JonasGMorsch/PI3/Proteus/placa esgrima.pdf

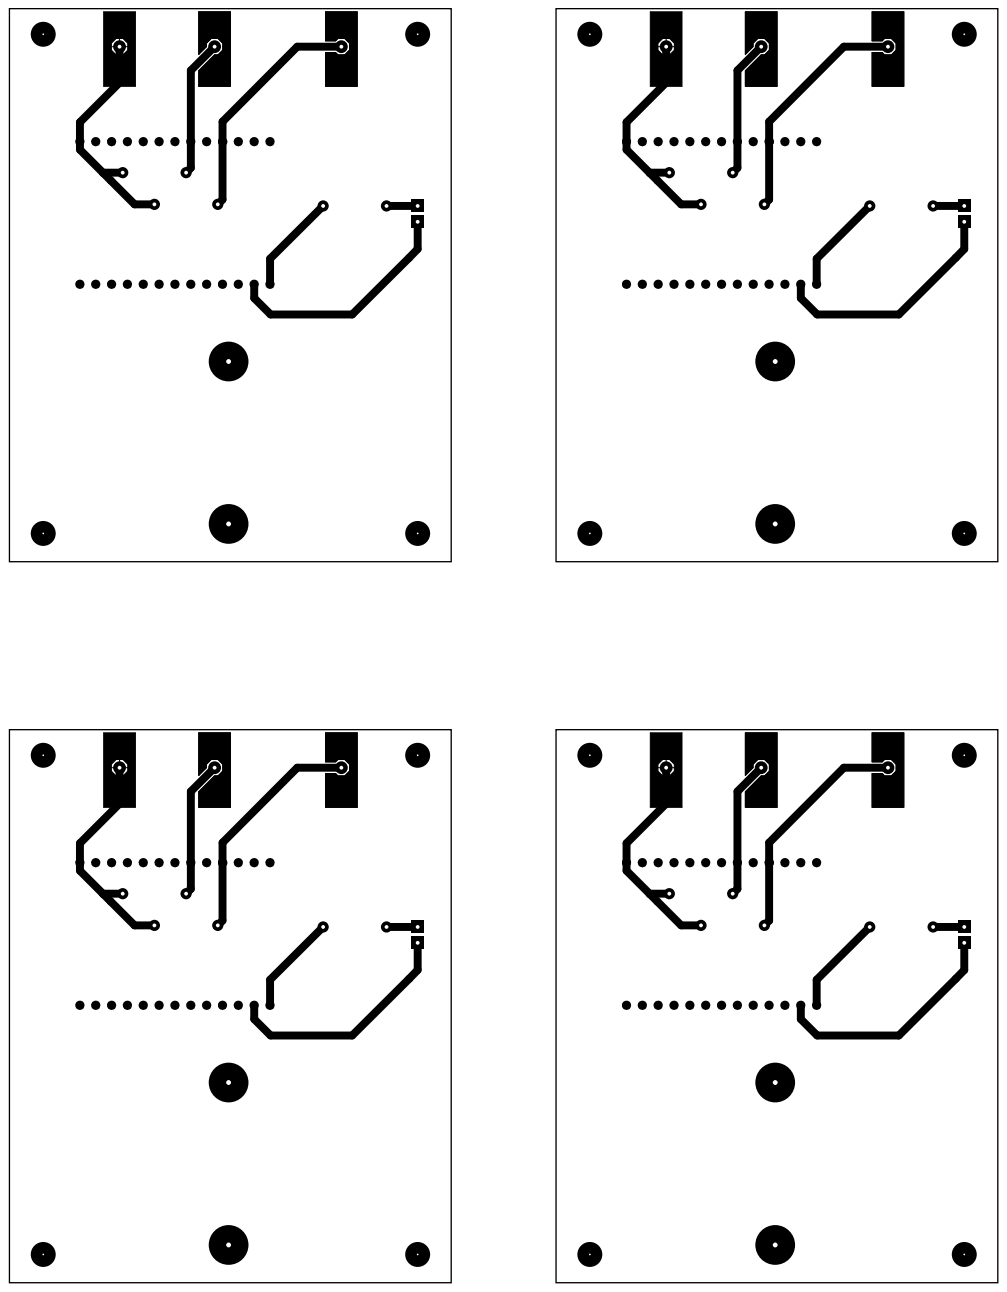
[picture p1: page 1]
