JonasGMorsch/PI3/(list of files, drawings)

Other design files:
Proteus/placa esgrima.pdsprj
Proteus/Teste Capacitancia 2.pdsprj
Proteus/Teste Capacitancia.pdsprj
