JonasGMorsch/PI3/(commit log)

2022-12-06 Movendo arquivos do projeto para o repositório
    [Teste Capacitancia.pdsprj, placa esgrima.pdsprj]
2022-12-06 movendo projetos de teste do ESP-IDF para o repositório
2022-12-07 devenvolvimento envio e recebmento via espnow
    [placa esgrima.pdsprj]
2022-12-07 desenvolvimento do timer & ADC
2022-12-09 testes com timers em hardware
2022-12-09 Passando tarefa de processamendo dos pacotes Wi-Fi para o core 1
2022-12-13 Habilitando Wi-Fi long range
    Este protocolo é mais lento, apenas 512KBp/s, porém não teve diferença mensurável no tempo de transmissão, fazendo válido o seu uso, já que o mesmo promete uma distância consideravelmente maior de transmissão.
2022-12-14 Implementando lógica do placar - limpeza de código
    [Teste Capacitancia 2.pdsprj]
2022-12-14 Otimização na detecção de empate - Limpeza de código
